DesignIV-Equipe4/EchoLink/Kicad/EchoLink/EchoLink.csv

Reference | Qty | Value | DNP | Exclude from BOM | Exclude from Board | Footprint | Datasheet | Manufacturer_Part_Number | DigitKey_Part_Number
C1,C2,C4,C5,C6,C7,C9,C12,C13,C17,C20,C21,C24,C26,C27 | 15 | 100nF |  |  |  | Capacitor_SMD:C_0603_1608Metric | https://www.digikey.ca/en/products/detail/kemet/C0603C104K5RACTU/1465594 | C0603C104K5RACTU | 399-C0603C104K5RACTUCT-ND
C3 | 1 | 4.7uF |  |  |  | Capacitor_SMD:C_0603_1608Metric | https://www.digikey.ca/en/products/detail/murata-electronics/GRM188R61E475KE11D/3900465 | GRM188R61E475KE11D | 490-7203-1-ND
C8,C19,C22,C28 | 4 | 10uF |  |  |  | Capacitor_SMD:C_0603_1608Metric | https://www.digikey.ca/en/products/detail/taiyo-yuden/LMK107BBJ106MALT/3662195 | LMK107BBJ106MALT | 587-3258-1-ND
C10,C14 | 2 | 22pF |  |  |  | Capacitor_SMD:C_0402_1005Metric | https://www.digikey.ca/en/products/detail/murata-electronics/GCM1555C1H220FA16D/7363195 | QSCT251Q220F1GV001E | 490-16451-1-ND
C11,C15 | 2 | 10nF |  |  |  | Capacitor_SMD:C_0402_1005Metric | https://www.digikey.ca/en/products/detail/murata-electronics/GRM155R71C103KA01D/587215 | GRM155R71C103KA01D | 490-1313-1-ND
C16,C23,C29 | 3 | 1uF |  |  |  | Capacitor_SMD:C_0603_1608Metric | https://www.digikey.ca/en/products/detail/kemet/C0603C105K4RACTU/2199788 | C0603C105K4RACTU | 399-C0603C105K4RACTUCT-ND
C18 | 1 | T520D227M010ATE018 |  |  |  | EchoLink_Lib:CAPMP7.6X4.3_3.1N_KEM | https://www.digikey.ca/en/products/detail/yageo/CC0603KRX7R9BB103/302819 | T520D227M010ATE018 | 399-4045-1-ND
C25,C30 | 2 | 10nF |  |  |  | Capacitor_SMD:C_0603_1608Metric | https://www.digikey.ca/en/products/detail/samsung-electro-mechanics/CL21B103KAANNNC/3888092 | CC0603KRX7R9BB103 | 311-1085-1-ND
D2,D3 | 2 | GREEN |  |  |  | Resistor_SMD:R_0603_1608Metric | https://www.digikey.ca/en/products/detail/qt-brightek-qtb/QBLP601-AG15/16499667 | QBLP601-AG15 | 1516-QBLP601-AG15CT-ND
FB1,FB2 | 2 | 120R |  |  |  | Resistor_SMD:R_0805_2012Metric | https://www.digikey.ca/en/products/detail/fair-rite-products-corp/2508051217Y6/8594305 | 2508051217Y6 | 1934-1472-1-ND
J1 | 1 | 142-0701-801 |  |  |  | EchoLink_Lib:CONN_142-0701-801 | https://www.digikey.ca/en/products/detail/cinch-connectivity-solutions-johnson/142-0701-801/35280 | 142-0701-801 | J502-ND
J2 | 1 | Conn_01x04 |  |  |  | EchoLink_Lib:CONN_SD-43045-008_04_MOL | https://www.digikey.ca/en/products/detail/molex/0430450423/3044577 | 0430450423 | WM7485-ND
J3 | 1 | Conn_02x04_Counter_Clockwise |  |  |  | EchoLink_Lib:CONN_SD-43045-008_08_MOL | https://www.digikey.ca/en/products/detail/molex/0430450821/1635026 | 0430450821 | WM2675-ND
J6 | 1 | Conn_01x03 |  |  |  | EchoLink_Lib:CONN_SD-43650-002_03_MOL | https://www.digikey.ca/en/products/detail/molex/0436500303/269000 | 0436500303 | 23-0436500303-ND
J7 | 1 | Conn_01x06_Pin |  |  |  | Connector_PinHeader_2.54mm:PinHeader_1x06_P2.54mm_Vertical
R1,R3,R4,R5,R9,R11,R14 | 7 | 10k |  |  |  | Resistor_SMD:R_0603_1608Metric | https://www.digikey.ca/en/products/detail/yageo/RC0603FR-0710KL/726880 | RC0603FR-0710KL | 311-10.0KHRCT-ND
R2,R8,R13,R17,R18 | 5 | 1.5k |  |  |  | Resistor_SMD:R_0603_1608Metric | https://www.digikey.ca/en/products/detail/panasonic-electronic-components/ERA-3AEB152V/1465858 | ERA-3AEB152V | P1.5KDBCT-ND
R6,R7,R12 | 3 | 22R |  |  |  | Capacitor_SMD:C_0603_1608Metric | https://www.digikey.ca/en/products/detail/stackpole-electronics-inc/RMCF0603FT22R0/1760726 | RMCF0603FT22R0 | RMCF0603FT22R0CT-ND
R10 | 1 | 10R |  |  |  | Resistor_SMD:R_0603_1608Metric | https://www.digikey.ca/en/products/detail/yageo/RC0805FR-0710RL/727534 | RC0805FR-0710RL | 311-10.0CRCT-ND
R15,R16 | 2 | 59R |  |  |  | Resistor_SMD:R_0603_1608Metric | https://www.digikey.ca/en/products/detail/koa-speer-electronics-inc/RK73H1JTTD59R0F/9845371 | RK73H1JTTD59R0F | 2019-RK73H1JTTD59R0FCT-ND
SW1,SW2 | 2 | PTS526 SM15 SMTR2 LFS |  |  |  | SON4_PTS526 SM15 SMTR2 LFS_CNK | https://www.digikey.ca/en/products/detail/c-k/PTS526SM15SMTR2-LFS/10056625 | PTS526SM15SMTR2 LFS | CKN12220-1-ND
TP1,TP2,TP3,TP4,TP5,TP6 | 6 | TestPoint |  |  |  | TestPoint:TestPoint_Pad_D1.0mm
U1 | 1 | STM32L433CCT6 |  |  |  | EchoLink_Lib:QFP50P900X900X160-48N | https://www.digikey.ca/en/products/detail/stmicroelectronics/STM32L433CCT6/6132750 | STM32L433CCT6 | 497-16579-ND
U2 | 1 | E22-400M33S | DNP |  |  | EchoLink_Lib:E22-400M33S | https://www.cdebyte.com/products/E22-400M33S/4#Downloads
U3 | 1 | ISOW1044 |  |  |  | EchoLink_Lib:ISOW1044BDFMR | https://www.digikey.com/en/products/detail/texas-instruments/ISOW1044BDFMR/18159254 | ISOW1044BDFMR | 296-ISOW1044BDFMRCT-ND
Y1 | 1 | WE-XTAL_HC49 |  |  |  | EchoLink_Lib:WE-XTAL_HC49 | https://www.digikey.ca/en/products/detail/w%C3%BCrth-elektronik/830050510/13900454 | 830050510 | 1923-830050510CT-ND
