DesignIV-Equipe4/EchoLink/Kicad/Components/142_0701_801/142-0701-801.step

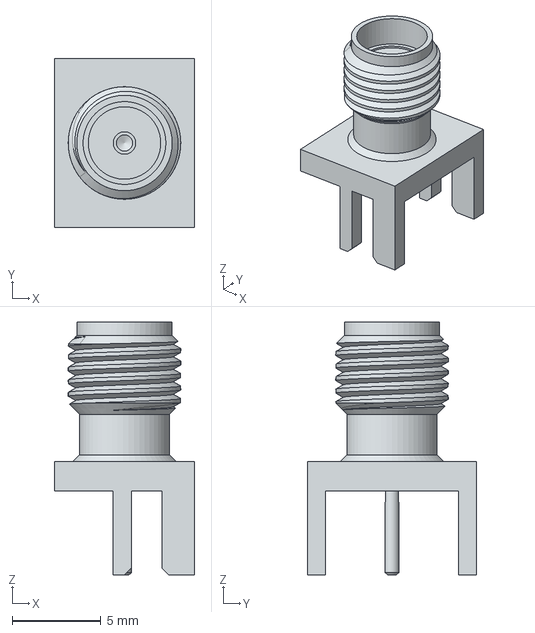
[picture p1: CAD file, 2026-09-06]
Kicad/Components/142_0701_801/142-0701-801.step
7.92 x 9.53 x 14.3 mm
