DesignIV-Equipe4/EchoLink/Kicad/Components/EEHZU1E471P/EEHZU1E471P.step

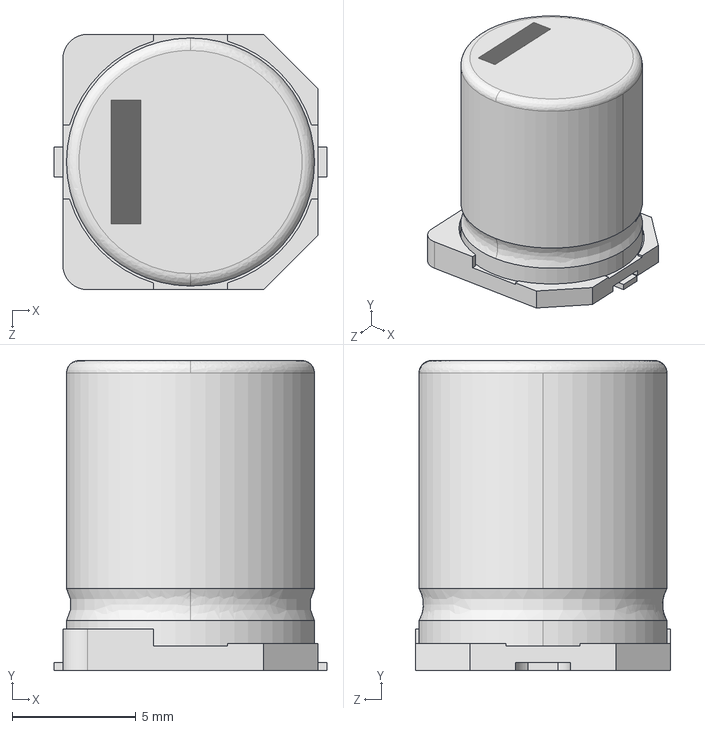
[picture p2: CAD file, 2026-09-08]
Kicad/Components/EEHZU1E471P/EEHZU1E471P.step
11.0 x 12.5 x 10.3 mm
