DesignIV-Equipe4/EchoLink/Kicad/Components/HM-11/HM11.stp

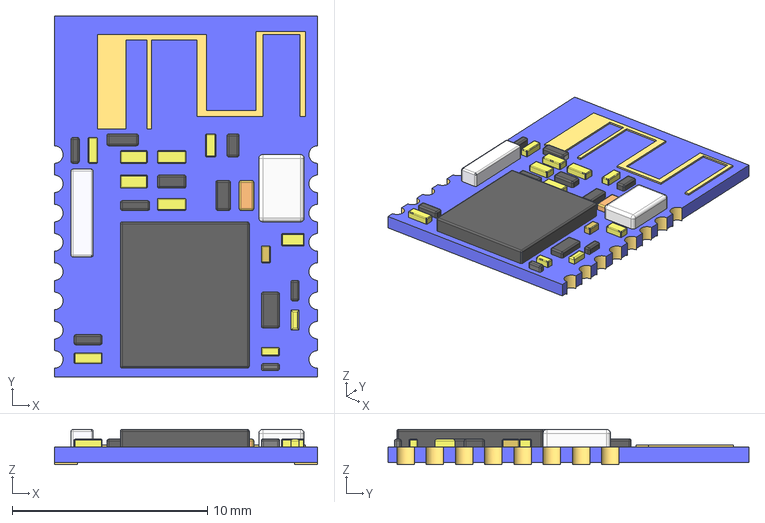
[picture p3: CAD file, 2026-09-06]
Kicad/Components/HM-11/HM11.stp
13.5 x 18.5 x 1.80 mm
