DesignIV-Equipe4/EchoLink/Kicad/Components/ISOW1044BDFMR/ISOW1044BDFMR.stp

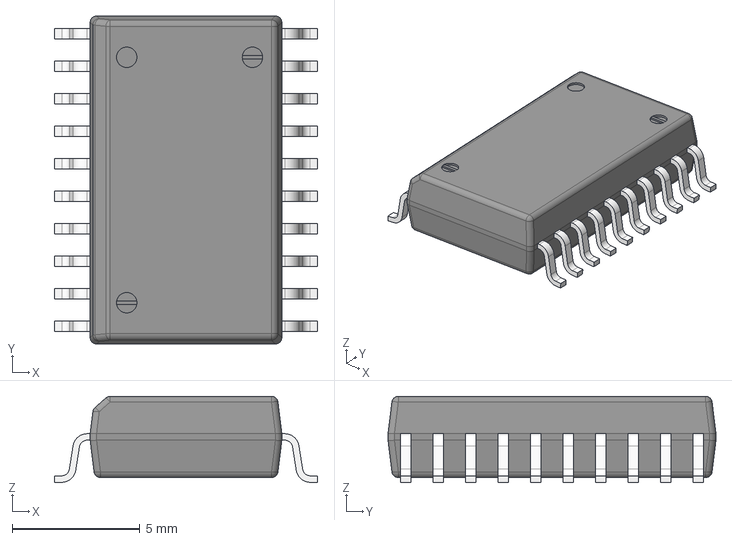
[picture p4: CAD file, 2026-10-04]
Kicad/Components/ISOW1044BDFMR/ISOW1044BDFMR.stp
10.3 x 12.8 x 3.38 mm
BODY-SSOP
LEAD-SSOP x 20
