DesignIV-Equipe4/EchoLink/Kicad/Components/MAX3221IPWR/MAX3221IPWR.step

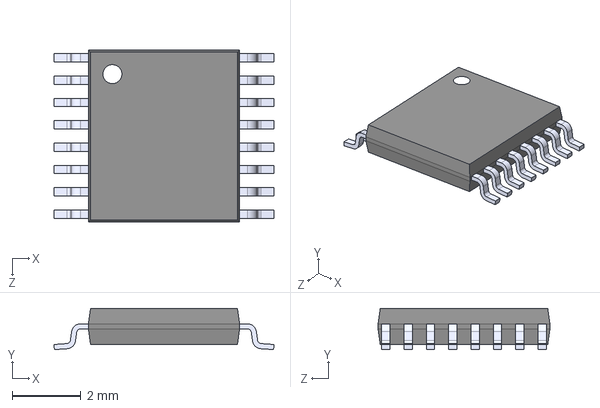
[picture p5: CAD file, 2026-09-06]
Kicad/Components/MAX3221IPWR/MAX3221IPWR.step
6.40 x 1.20 x 5.00 mm
