DesignIV-Equipe4/EchoLink/Kicad/Components/STM32L433CCT6/STM32L433CCT6.step

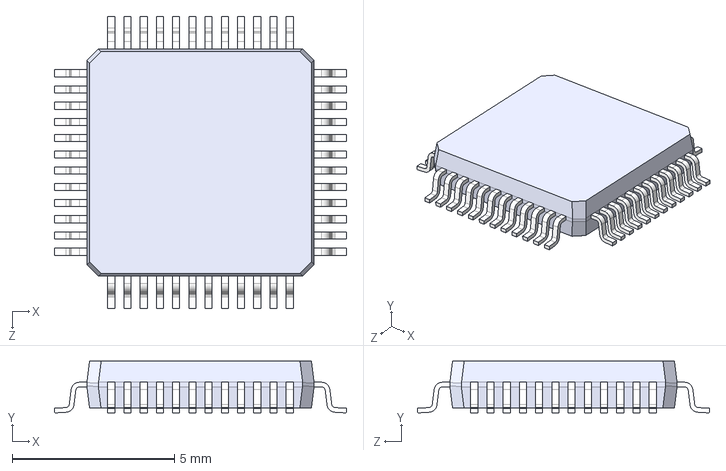
[picture p6: CAD file, 2026-09-06]
Kicad/Components/STM32L433CCT6/STM32L433CCT6.step
9.00 x 1.60 x 9.00 mm
