DesignIV-Equipe4/EchoLink/Kicad/Components/T520D227M010ATE018/T520D227M010ATE018.step

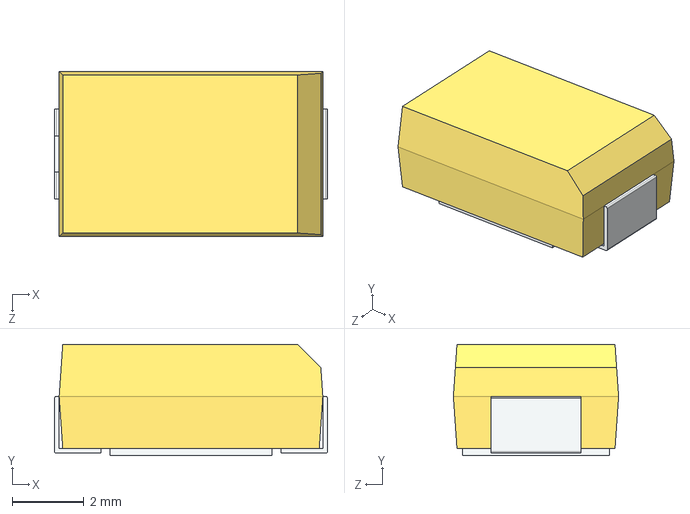
[picture p7: CAD file, 2026-11-02]
Kicad/Components/T520D227M010ATE018/T520D227M010ATE018.step
7.60 x 3.10 x 4.60 mm
