DesignIV-Equipe4/EchoLink/Kicad/Components/WE-XTAL_HC49/WE-XTAL_HC49.step

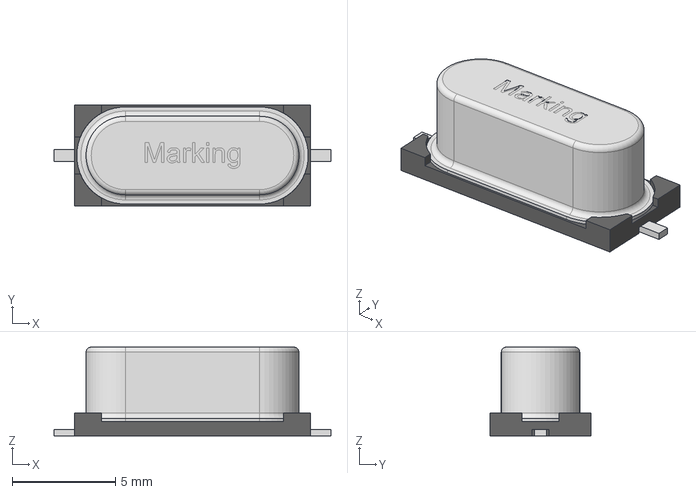
[picture p8: CAD file, 2026-10-06]
Kicad/Components/WE-XTAL_HC49/WE-XTAL_HC49.step
13.4 x 4.90 x 4.30 mm
Base
Housing
