DesignIV-Equipe4/EchoLink/Kicad/Components/430450423/430450423.stp

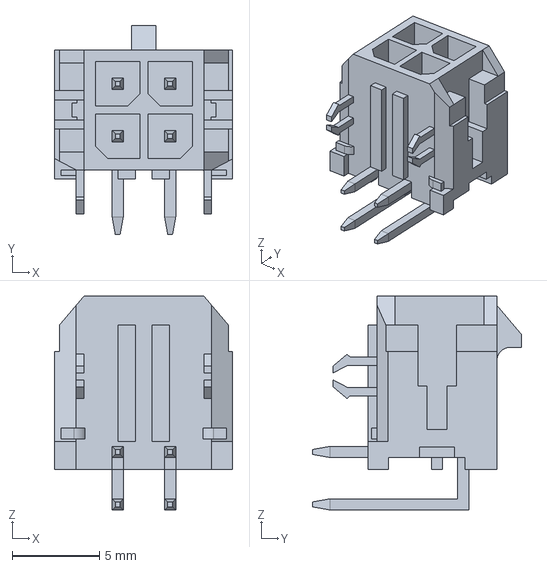
[picture p9: CAD file, 2026-11-09]
Kicad/Components/430450423/430450423.stp
10.2 x 11.9 x 12.2 mm
