DesignIV-Equipe4/EchoLink/Kicad/Components/430451021/430451021.step

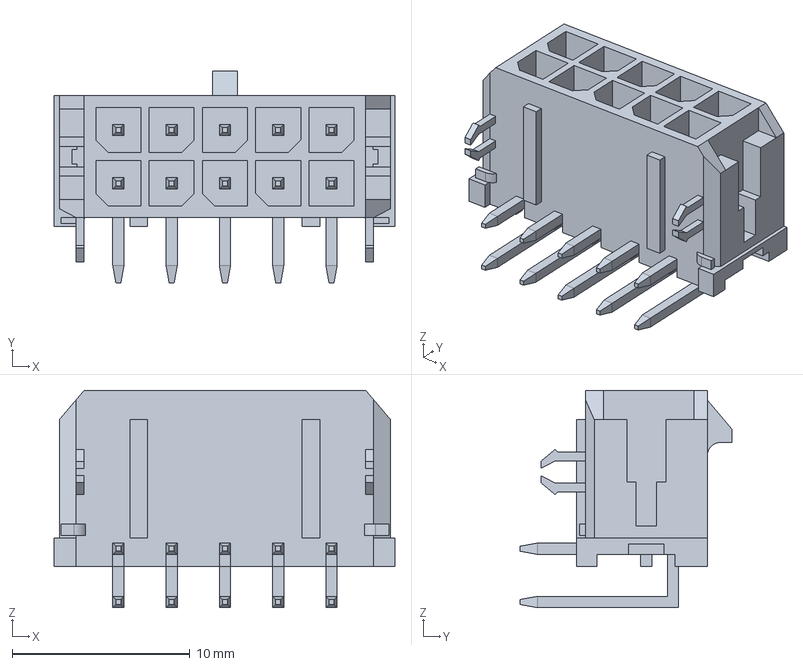
[picture p10: CAD file, 2026-11-02]
Kicad/Components/430451021/430451021.step
19.2 x 11.9 x 12.2 mm
