DesignIV-Equipe4/EchoLink/Kicad/Components/436500203/436500203.stp

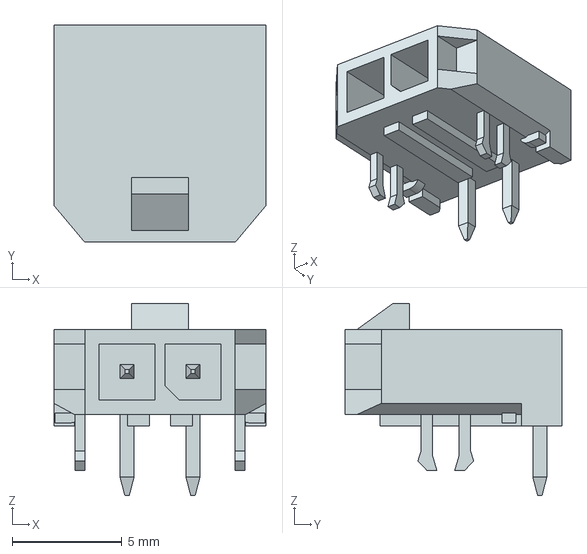
[picture p11: CAD file, 2026-11-02]
Kicad/Components/436500203/436500203.stp
9.65 x 9.90 x 8.75 mm
