DesignIV-Equipe4/EchoLink/Kicad/Components/436500303/436500303.stp

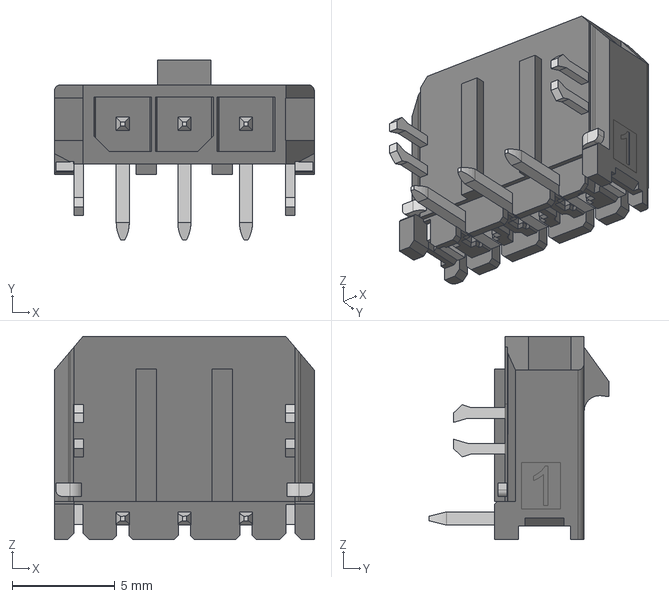
[picture p12: CAD file, 2026-11-02]
Kicad/Components/436500303/436500303.stp
12.7 x 8.75 x 9.90 mm
