DesignIV-Equipe4/EchoLink/Kicad/Components/436500404/436500404.step

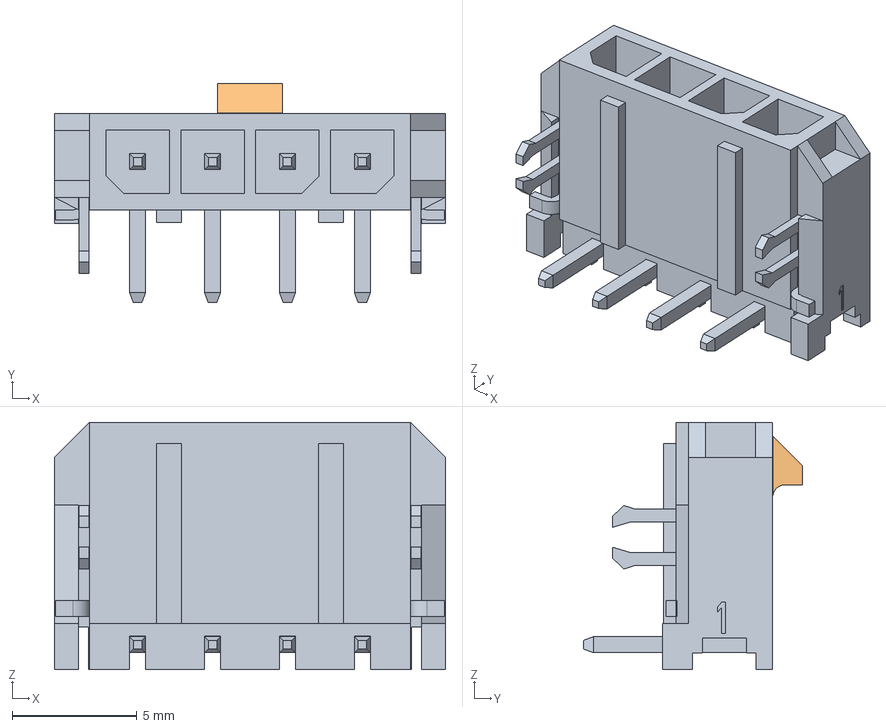
[picture p13: CAD file, 2026-09-06]
Kicad/Components/436500404/436500404.step
15.7 x 8.79 x 9.90 mm
