DesignIV-Equipe4/EchoLink/Kicad/Components/436500900/436500900.stp

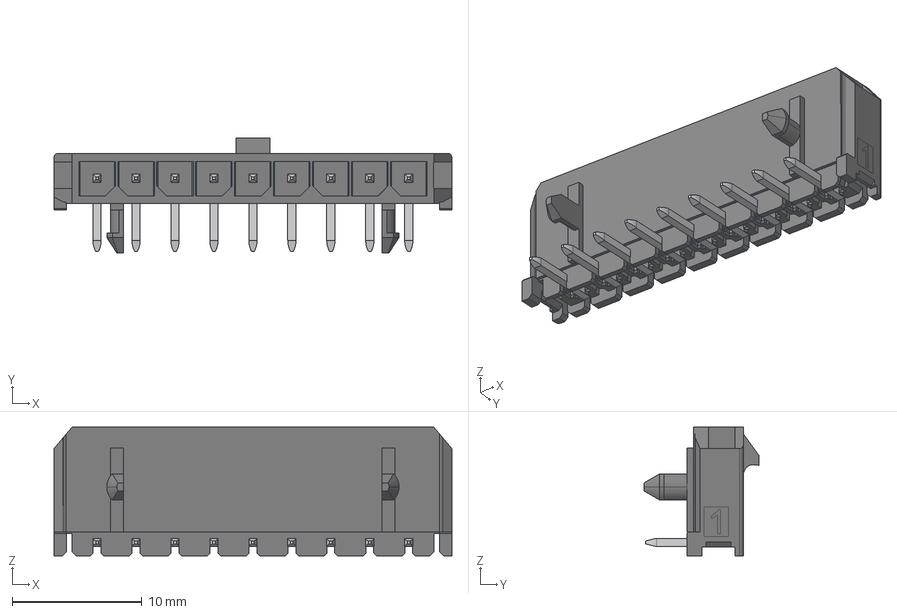
[picture p14: CAD file, 2026-11-02]
Kicad/Components/436500900/436500900.stp
30.6 x 8.87 x 9.90 mm
