DesignIV-Equipe4/EchoLink/(list of files, drawings)

Other design files:
Kicad/Components/E22-400M33S/E22-400M33S.PcbLib
