DesignIV-Equipe4/EchoLink/Kicad/EchoLink/EchoLink.kicad_pcb

## KiCad design Kicad/EchoLink/EchoLink.kicad_pcb (2026-11-11)

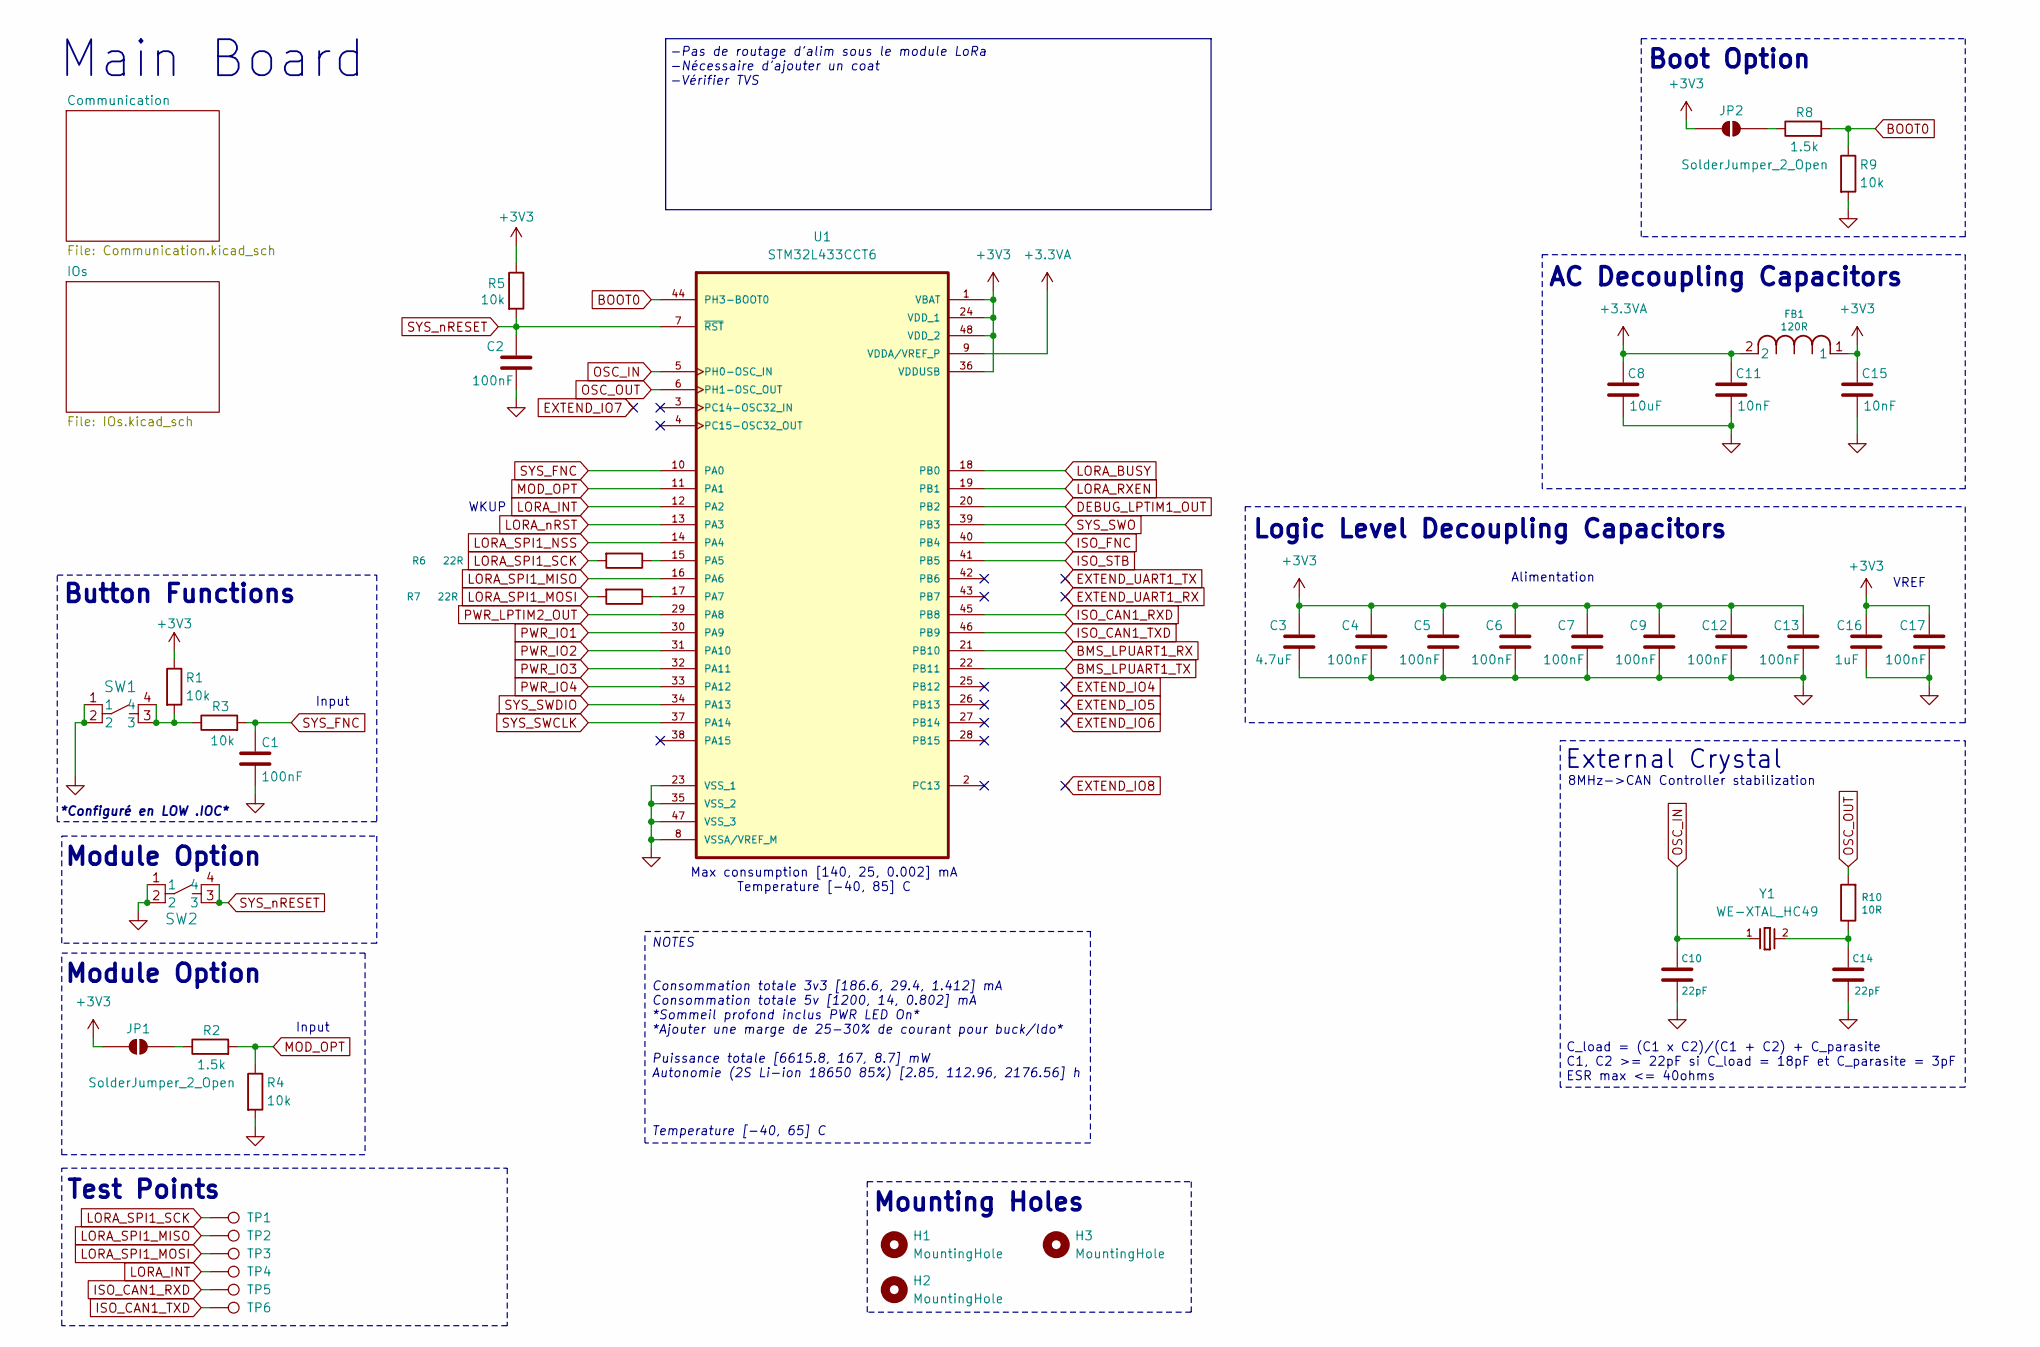
[picture p15: schematic EchoLink.kicad_sch]

Parts:
C1, C2, C4, C5, C6, C7, C9, C12, C13, C17: 100nF; C_0603_1608Metric; Manufacturer_Part_Number C0603C104K5RACTU; DigiKey_Part_Number 311-3342-1-ND
C3: 4.7uF; C_0603_1608Metric; Manufacturer_Part_Number GRM188R61E475KE11D; DigiKey_Part_Number 311-3342-1-ND
C8: 10uF; C_0603_1608Metric; Manufacturer_Part_Number LMK107BBJ106MALT; DigiKey_Part_Number 4713-GMC10X5R106M35NTTR-ND
C10, C14: 22pF; C_0402_1005Metric; Manufacturer_Part_Number QSCT251Q220F1GV001E; DigiKey_Part_Number 712-QSCT251Q220F1GV001ECT-ND
C11, C15: 10nF; C_0402_1005Metric; Manufacturer_Part_Number GRM155R71C103KA01D; DigiKey_Part_Number 490-1313-1-ND
C16: 1uF; C_0603_1608Metric; Manufacturer_Part_Number C0603C105K4RACTU; DigiKey_Part_Number 311-3342-1-ND
FB1: 120R; R_0805_2012Metric; Manufacturer_Part_Number 2508051217Y6; DigiKey_Part_Number 1934-1472-1-ND
H1, H2, H3: MountingHole; MountingHole_2.2mm_M2_Pad_Via
JP1, JP2: SolderJumper_2_Open; SolderJumper-2_P1.3mm_Open_RoundedPad1.0x1.5mm
R1, R4, R5, R9: 10k; R_0603_1608Metric; Manufacturer_Part_Number RC0603FR-0710KL; DigiKey_Part_Number 311-10.0KHRCT-ND
R2, R8: 1.5k; R_0603_1608Metric; Manufacturer_Part_Number ERA-3AEB152V; DigiKey_Part_Number P1.5KDBCT-ND
R3: 10k; R_0603_1608Metric; Manufacturer_Part_Number RC0603FR-0710KL; DigiKey_Part_Number P1.5KDBCT-ND
R6, R7: 22R; C_0603_1608Metric; Manufacturer_Part_Number RMCF0603FT22R0; DigiKey_Part_Number YAG3460CT-ND
R10: 10R; R_0603_1608Metric; Manufacturer_Part_Number RC0805FR-0710RL; DigiKey_Part_Number 311-10.0CRCT-ND
SW1, SW2: PTS526 SM15 SMTR2 LFS; SON4_PTS526 SM15 SMTR2 LFS_CNK; Manufacturer_Part_Number PTS526SM15SMTR2 LFS; DigitKey_Part_Number CKN12220-1-ND
TP1, TP2, TP3, TP4, TP5, TP6: TestPoint; TestPoint_Pad_D1.0mm
U1: STM32L433CCT6; QFP50P900X900X160-48N; Manufacturer_Part_Number STM32L433CCT6; DigiKey_Part_Number 497-16579-ND
Y1: WE-XTAL_HC49; Manufacturer_Part_Number 830050510; DigiKey_Part_Number 1923-830050510CT-ND

Connections:
+3.3VA: C8.1, C11.1, FB1.2, U1.9 (VDDA/VREF_P)
+3V3: C3.1, C4.1, C5.1, C6.1, C7.1, C9.1, C12.1, C13.1, C15.1, C16.1, C17.1, FB1.1, JP1.1 (A), JP2.1 (A), R1.1, R5.1, U1.1 (VBAT), U1.24 (VDD_1), U1.36 (VDDUSB), U1.48 (VDD_2); also elsewhere on the board
BMS_LPUART1_RX: U1.21 (PB10); also elsewhere on the board
BMS_LPUART1_TX: U1.22 (PB11); also elsewhere on the board
BOOT0: R8.2, R9.1, U1.44 (PH3-BOOT0)
DEBUG_LPTIM1_OUT: U1.20 (PB2); also elsewhere on the board
GND: C1.2, C2.2, C3.2, C4.2, C5.2, C6.2, C7.2, C8.2, C9.2, C10.1, C11.2, C12.2, C13.2, C14.1, C15.2, C16.2, C17.2, R4.2, R9.2, SW1.1, SW1.2, SW2.1, SW2.2, U1.8 (VSSA/VREF_M), U1.23 (VSS_1), U1.35 (VSS_2), U1.47 (VSS_3); also elsewhere on the board
ISO_CAN1_RXD: TP5.1 (1_1), U1.45 (PB8); also elsewhere on the board
ISO_CAN1_TXD: TP6.1 (1_1), U1.46 (PB9); also elsewhere on the board
ISO_FNC: U1.40 (PB4); also elsewhere on the board
ISO_STB: U1.41 (PB5); also elsewhere on the board
LORA_BUSY: U1.18 (PB0); also elsewhere on the board
LORA_INT: TP4.1 (1_1), U1.12 (PA2); also elsewhere on the board
LORA_RXEN: U1.19 (PB1); also elsewhere on the board
LORA_SPI1_MISO: TP2.1 (1_1), U1.16 (PA6); also elsewhere on the board
LORA_SPI1_MOSI: R7.2, TP3.1 (1_1); also elsewhere on the board
LORA_SPI1_NSS: U1.14 (PA4); also elsewhere on the board
LORA_SPI1_SCK: R6.2, TP1.1 (1_1); also elsewhere on the board
LORA_nRST: U1.13 (PA3); also elsewhere on the board
MOD_OPT: R2.2, R4.1, U1.11 (PA1)
unnamed: C14.2, R10.1, Y1.2
unnamed: JP1.2 (B), R2.1
unnamed: JP2.2 (B), R8.1
unnamed: R1.2, R3.1, SW1.3, SW1.4
unnamed: R6.1, U1.15 (PA5)
unnamed: R7.1, U1.17 (PA7)
OSC_IN: C10.2, U1.5 (PH0-OSC_IN), Y1.1
OSC_OUT: R10.2, U1.6 (PH1-OSC_OUT)
PWR_IO1: U1.30 (PA9); also elsewhere on the board
PWR_IO2: U1.31 (PA10); also elsewhere on the board
PWR_IO3: U1.32 (PA11); also elsewhere on the board
PWR_IO4: U1.33 (PA12); also elsewhere on the board
PWR_LPTIM2_OUT: U1.29 (PA8); also elsewhere on the board
SYS_FNC: C1.1, R3.2, U1.10 (PA0)
SYS_SWCLK: U1.37 (PA14); also elsewhere on the board
SYS_SWDIO: U1.34 (PA13); also elsewhere on the board
SYS_SWO: U1.39 (PB3); also elsewhere on the board
SYS_nRESET: C2.1, R5.2, SW2.3, SW2.4, U1.7 (~RST); also elsewhere on the board

Notes on the sheet:
Module Option
8MHz->CAN Controller stabilization
*Configuré en LOW .IOC*
WKUP
External Crystal
Main Board
AC Decoupling Capacitors
Logic Level Decoupling Capacitors
Boot Option
Input
C_load = (C1 x C2)/(C1 + C2) + C_parasite C1, C2 >= 22pF si C_load = 18pF et C_parasite = 3pF ESR max <= 40ohms
VREF
-Pas de routage d'alim sous le module LoRa -Nécessaire d'ajouter un coat -Vérifier TVS
Test Points
Alimentation
Max consumption [140, 25, 0.002] mA Temperature [-40, 85] C
NOTES Consommation totale 3v3 [186.6, 29.4, 1.412] mA Consommation totale 5v [1200, 14, 0.802] mA *Sommeil profond inclus PWR LED On* *Ajouter une marge de 25-30% de courant pour buck/ldo* Puissance totale [6615.8, 167, 8.7] mW Autonomie (2S Li-ion 18650 85%) [2.85, 112.96, 2176.56] h Temperature [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
Mounting Holes
Button Functions

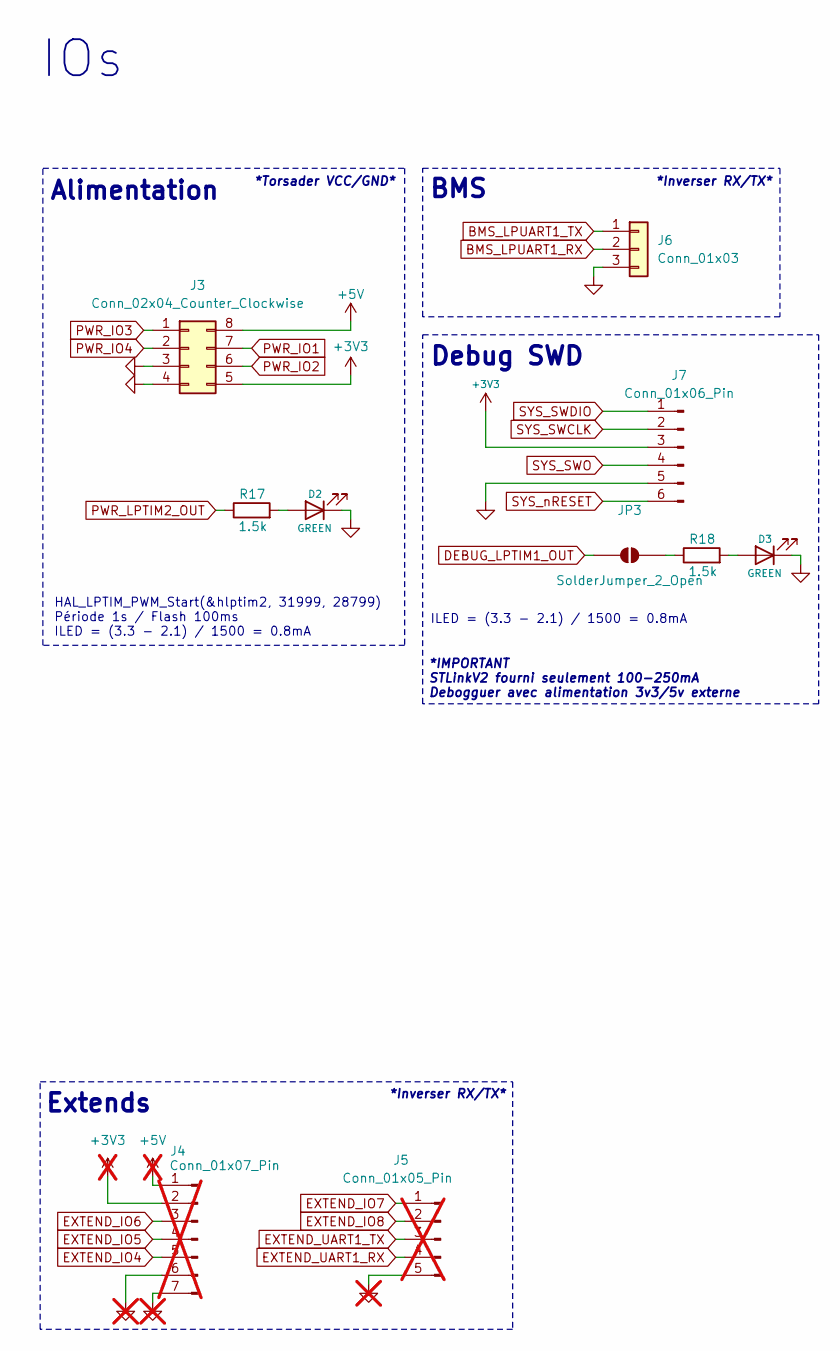
[picture p16: schematic IOs.kicad_sch]

Parts:
D2, D3: GREEN; R_0603_1608Metric; Manufacturer_Part_Number QBLP601-AG15; DigiKey_Part_Number 1516-QBLP601-AG15CT-ND
J3: Conn_02x04_Counter_Clockwise; CONN_SD-43045-008_08_MOL; Manufacturer_Part_Number 0430450821; DigitKey_Part_Number WM2675-ND
J4: Conn_01x07_Pin; PinHeader_1x07_P2.54mm_Vertical; not fitted
J5: Conn_01x05_Pin; PinHeader_1x05_P2.54mm_Vertical; not fitted
J6: Conn_01x03; CONN_SD-43650-002_03_MOL; Manufacturer_Part_Number 0436500303; DigitKey_Part_Number 23-0436500303-ND
J7: Conn_01x06_Pin; PinHeader_1x06_P2.54mm_Vertical
JP3: SolderJumper_2_Open; SolderJumper-2_P1.3mm_Open_RoundedPad1.0x1.5mm
R17, R18: 1.5k; R_0603_1608Metric; Manufacturer_Part_Number ERA-3AEB152V; DigiKey_Part_Number P1.5KDBCT-ND

Connections:
+3V3: J3.5, J4.2, J7.3; also elsewhere on the board
+5V: J3.8, J4.1; also elsewhere on the board
BMS_LPUART1_RX: J6.2; also elsewhere on the board
BMS_LPUART1_TX: J6.1; also elsewhere on the board
DEBUG_LPTIM1_OUT: JP3.1 (A); also elsewhere on the board
GND: D2.1 (K), D3.1 (K), J3.3, J3.4, J4.6, J4.7, J5.5, J6.3, J7.5; also elsewhere on the board
unnamed: D2.2 (A), R17.2
unnamed: D3.2 (A), R18.2
unnamed: JP3.2 (B), R18.1
PWR_IO1: J3.7; also elsewhere on the board
PWR_IO2: J3.6; also elsewhere on the board
PWR_IO3: J3.1; also elsewhere on the board
PWR_IO4: J3.2; also elsewhere on the board
PWR_LPTIM2_OUT: R17.1; also elsewhere on the board
SYS_SWCLK: J7.2; also elsewhere on the board
SYS_SWDIO: J7.1; also elsewhere on the board
SYS_SWO: J7.4; also elsewhere on the board
SYS_nRESET: J7.6; also elsewhere on the board

Notes on the sheet:
IOs
BMS
Extends
*Inverser RX/TX*
*IMPORTANT STLinkV2 fourni seulement 100-250mA Debogguer avec alimentation 3v3/5v externe
HAL_LPTIM_PWM_Start(&hlptim2, 31999, 28799) Période 1s / Flash 100ms ILED = (3.3 - 2.1) / 1500 = 0.8mA
Debug SWD
Alimentation
*Torsader VCC/GND*
ILED = (3.3 - 2.1) / 1500 = 0.8mA

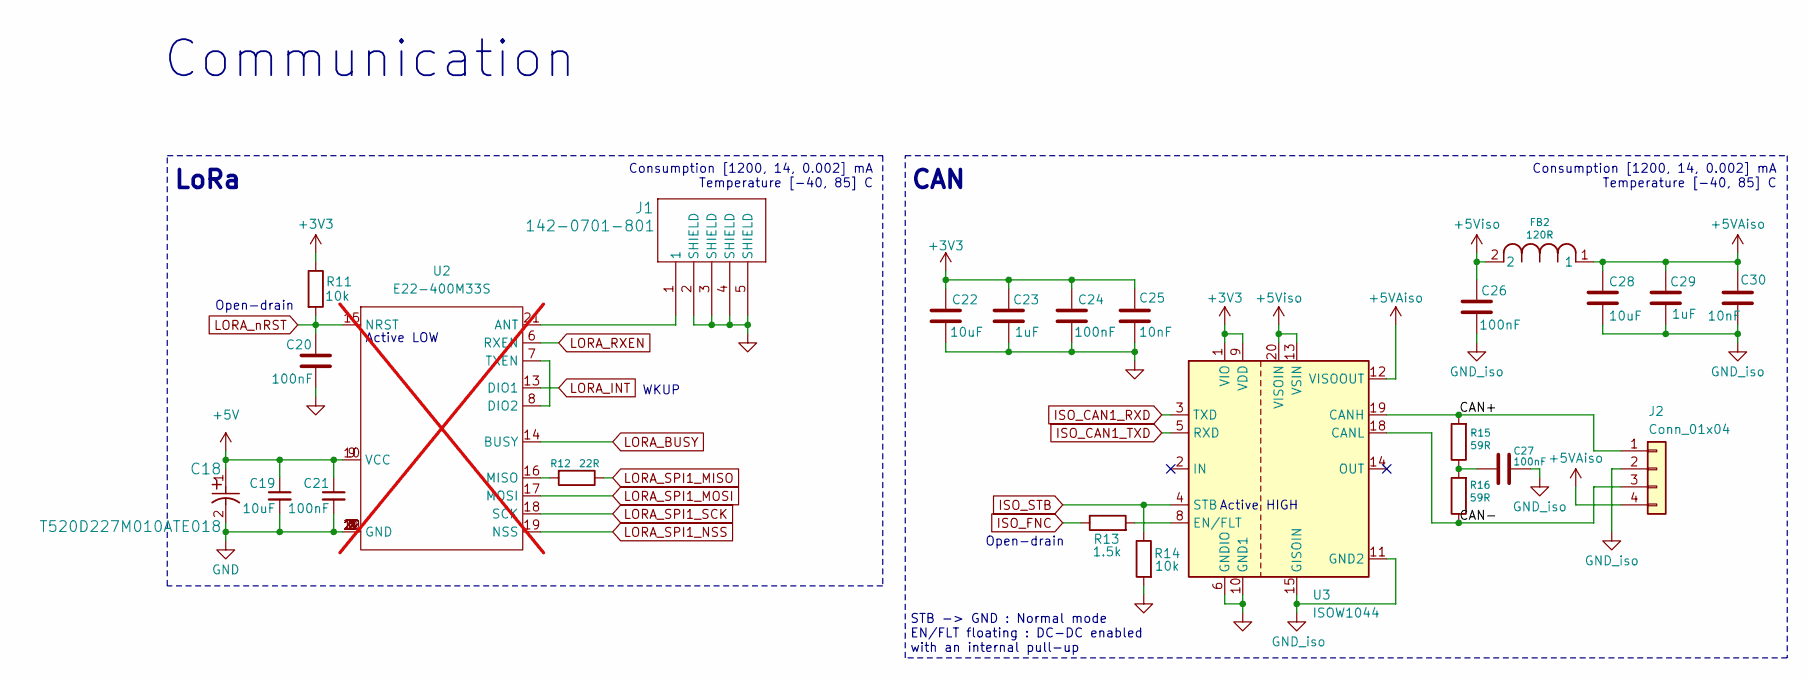
[picture p17: schematic Communication.kicad_sch]

Parts:
C18: T520D227M010ATE018; CAPMP7.6X4.3_3.1N_KEM; Manufacturer_Part_Number T520D227M010ATE018; DigitKey_Part_Number 399-4045-1-ND
C19: 10uF; C_0603_1608Metric; Manufacturer_Part_Number LMK107BBJ106MALT; DigitKey_Part_Number 587-3258-1-ND
C20: 100nF; C_0603_1608Metric; Manufacturer_Part_Number C0603C104K5RACTU; DigiKey_Part_Number 311-3342-1-ND
C21: 100nF; C_0603_1608Metric; Manufacturer_Part_Number C0603C104K5RACTU; DigitKey_Part_Number 399-C0603C104K5RACTUCT-ND
C22, C28: 10uF; C_0603_1608Metric; Manufacturer_Part_Number LMK107BBJ106MALT; DigiKey_Part_Number 1276-2891-1-ND
C23, C29: 1uF; C_0603_1608Metric; Manufacturer_Part_Number C0603C105K4RACTU; DigiKey_Part_Number 1276-1029-1-ND
C24, C26, C27: 100nF; C_0603_1608Metric; Manufacturer_Part_Number C0603C104K5RACTU; DigiKey_Part_Number 399-C0603C104K3RACTUCT-ND
C25, C30: 10nF; C_0603_1608Metric; Manufacturer_Part_Number CC0603KRX7R9BB103; DigiKey_Part_Number 1276-2434-1-ND
FB2: 120R; R_0805_2012Metric; Manufacturer_Part_Number 2508051217Y6; DigiKey_Part_Number 1934-1472-1-ND
J1: 142-0701-801; CONN_142-0701-801; Manufacturer_Part_Number 142-0701-801; DigitKey_Part_Number J502-ND
J2: Conn_01x04; CONN_SD-43045-008_04_MOL; Manufacturer_Part_Number 0430450423; DigitKey_Part_Number WM7485-ND
R11, R14: 10k; R_0603_1608Metric; Manufacturer_Part_Number RC0603FR-0710KL; DigiKey_Part_Number 311-10.0KHRCT-ND
R12: 22R; C_0603_1608Metric; Manufacturer_Part_Number RMCF0603FT22R0; DigiKey_Part_Number YAG3460CT-ND
R13: 1.5k; R_0603_1608Metric; Manufacturer_Part_Number ERA-3AEB152V; DigiKey_Part_Number P1.5KDBCT-ND
R15, R16: 59R; R_0603_1608Metric; Manufacturer_Part_Number RK73H1JTTD59R0F; DigiKey_Part_Number 311-59.0CRCT-ND
U2: E22-400M33S; not fitted
U3: ISOW1044; ISOW1044BDFMR; Manufacturer_Part_Number ISOW1044BDFMR; DigiKey_Part_Number 296-ISOW1044BDFMRCT-ND

Connections:
+3V3: C22.1, C23.1, C24.1, C25.1, R11.1, U3.1 (VIO), U3.9 (VDD); also elsewhere on the board
+5V: C18.1, C19.1, C21.1, U2.9 (VCC), U2.10 (VCC); also elsewhere on the board
+5VAiso: C28.1, C29.1, C30.1, FB2.1, J2.4, U3.12 (VISOOUT); also elsewhere on the board
+5Viso: C26.1, FB2.2, U3.13 (VSIN), U3.20 (VISOIN)
/Communication/CAN+: J2.1, R15.2, U3.19 (CANH)
/Communication/CAN-: J2.3, R16.1, U3.18 (CANL)
GND: C18.2, C19.2, C20.2, C21.2, C22.2, C23.2, C24.2, C25.2, J1.2 (SHIELD), J1.3 (SHIELD), J1.4 (SHIELD), J1.5 (SHIELD), R14.2, U2.0 (GND), U2.1 (GND), U2.2 (GND), U2.3 (GND), U2.4 (GND), U2.5 (GND), U2.11 (GND), U2.12 (GND), U2.20 (GND), U2.22 (GND), U3.6 (GNDIO), U3.10 (GND1); also elsewhere on the board
GND_iso: C26.2, C27.2, C28.2, C29.2, C30.2, J2.2, U3.11 (GND2), U3.15 (GISOIN), U3.16 (GISOIN), U3.17 (GISOIN); also elsewhere on the board
ISO_CAN1_RXD: U3.3 (TXD); also elsewhere on the board
ISO_CAN1_TXD: U3.5 (RXD); also elsewhere on the board
ISO_FNC: R13.1; also elsewhere on the board
ISO_STB: R14.1, U3.4 (STB); also elsewhere on the board
LORA_BUSY: U2.14 (BUSY); also elsewhere on the board
LORA_INT: U2.13 (DIO1); also elsewhere on the board
LORA_RXEN: U2.6 (RXEN); also elsewhere on the board
LORA_SPI1_MISO: R12.1; also elsewhere on the board
LORA_SPI1_MOSI: U2.17 (MOSI); also elsewhere on the board
LORA_SPI1_NSS: U2.19 (NSS); also elsewhere on the board
LORA_SPI1_SCK: U2.18 (SCK); also elsewhere on the board
LORA_nRST: C20.1, R11.2, U2.15 (NRST); also elsewhere on the board
unnamed: C27.1, R15.1, R16.2
unnamed: J1.1, U2.21 (ANT)
unnamed: U2.7 (TXEN), U2.8 (DIO2)
unnamed: R12.2, U2.16 (MISO)
unnamed: R13.2, U3.8 (EN/FLT)

Notes on the sheet:
WKUP
Active HIGH
Open-drain
Consumption [1200, 14, 0.002] mA Temperature [-40, 85] C
Communication
STB -> GND : Normal mode EN/FLT floating : DC-DC enabled with an internal pull-up
LoRa
Active LOW
CAN

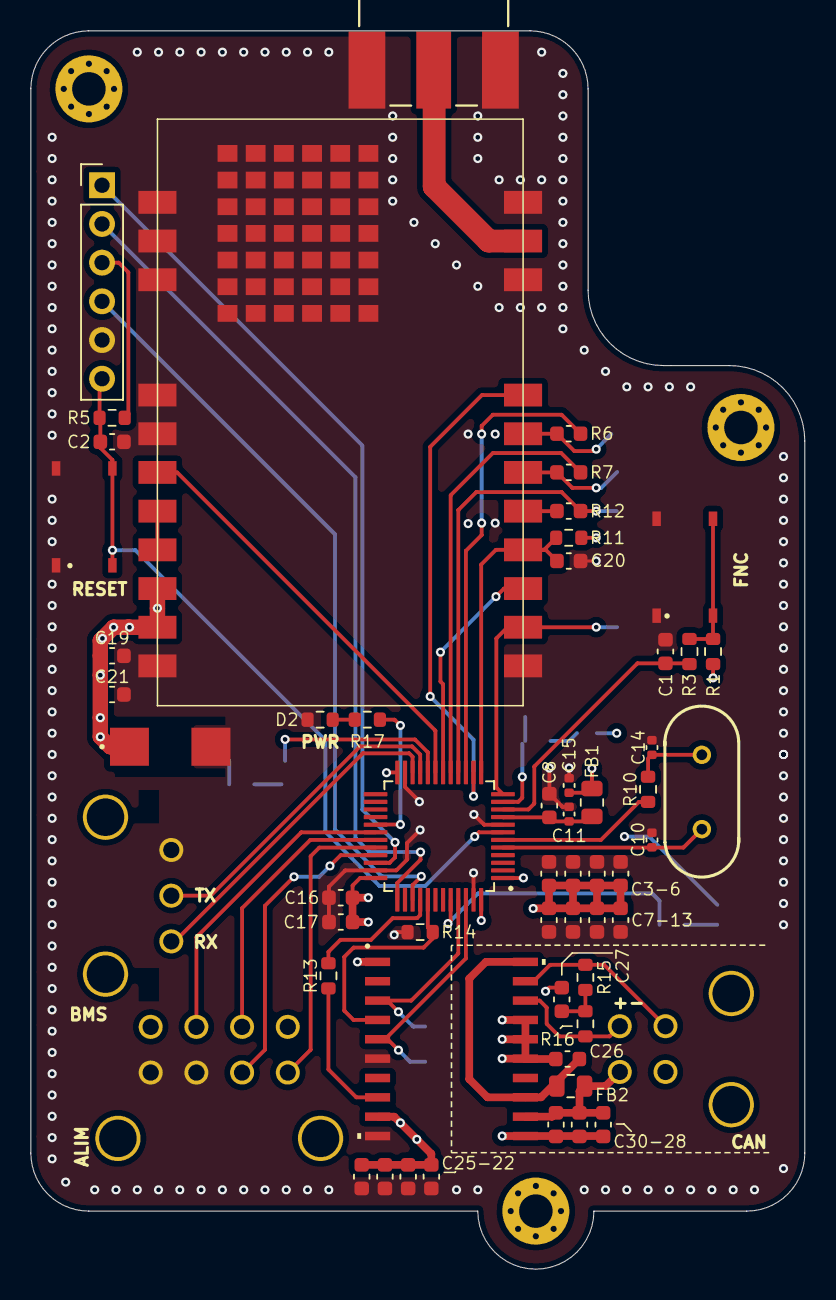
[picture p18: board EchoLink.kicad_pcb from above]

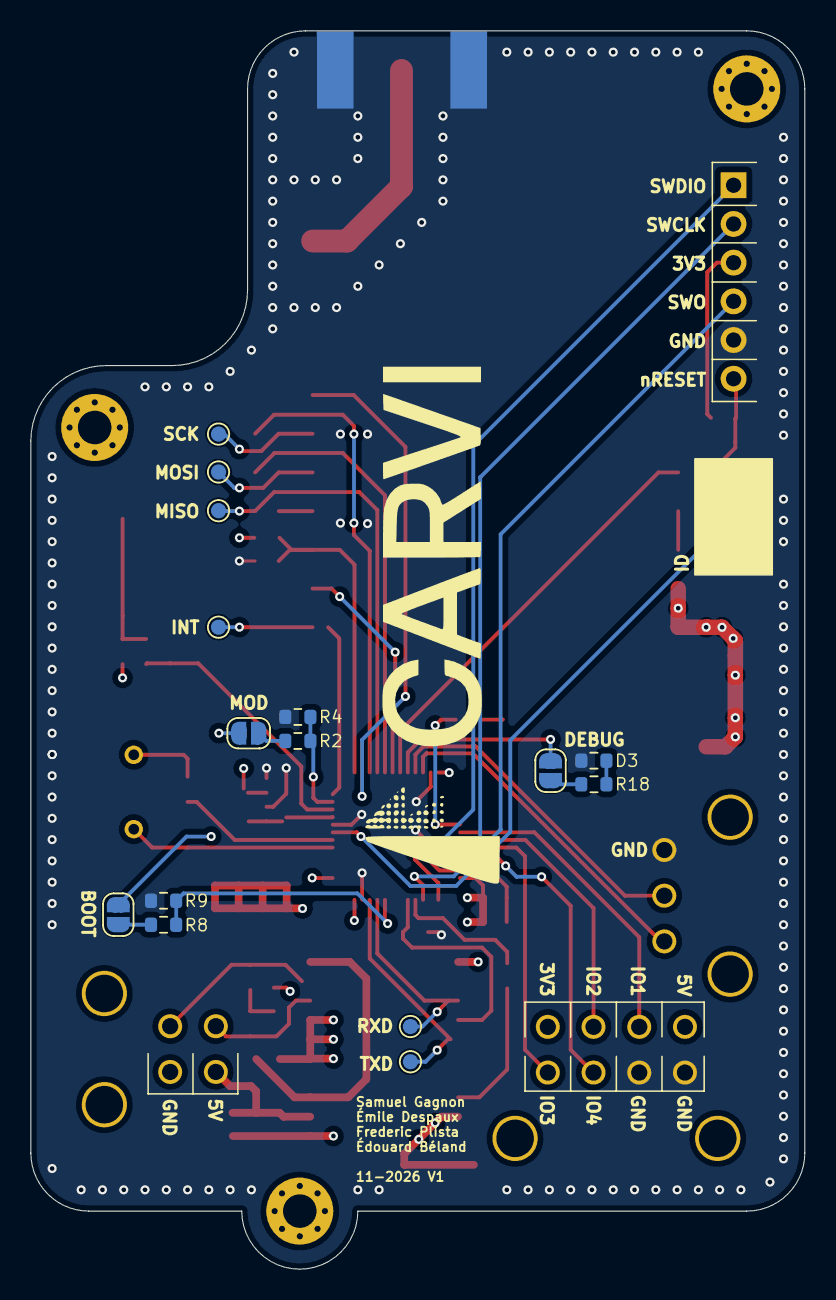
[picture p19: board EchoLink.kicad_pcb from below]

Board: 4 copper layers, 50.8 x 81.3 mm, 76 parts (16 on the bottom side), 52 nets.

Other parts of the board:
C3-6: 4.7uF; C_0603_1608Metric
C7-13: 100nF; C_0603_1608Metric
C25-22, C30-28: 10uF; C_0603_1608Metric
G1: LOGO; Carvi

Their connections:
+3V3: C3-6.1, C7-13.1, C25-22.1; also elsewhere on the board
+5VAiso: C30-28.1; also elsewhere on the board
GND: C3-6.2, C7-13.2, C25-22.2; also elsewhere on the board
GND_iso: C30-28.2; also elsewhere on the board
