DesignIV-Equipe4/EchoLink/STM32CubeIDE/EchoLink/EchoLink.ioc

Mcu.UserName=STM32L433CCTx
PA0.GPIO_Label=SYS_FNC
PA0.Signal=SYS_WKUP1
PA1.GPIO_Label=MOD_OPT
PA1.Signal=GPIO_Input
PA10.GPIO_Label=PWR_IO2
PA10.Signal=GPIO_Output
PA11.GPIO_Label=PWR_IO3
PA11.Signal=GPIO_Output
PA12.GPIO_Label=PWR_IO4
PA12.Signal=GPIO_Output
PA2.GPIO_Label=LORA_INT
PA2.Signal=SYS_WKUP4
PA3.GPIO_Label=LORA_nRST
PA3.Signal=GPIO_Output
PA4.GPIO_Label=LORA_SPI1_NSS
PA4.Signal=GPIO_Output
PA5.GPIO_Label=LORA_SPI1_SCK
PA5.Signal=SPI1_SCK
PA6.GPIO_Label=LORA_SPI1_MISO
PA6.Signal=SPI1_MISO
PA7.GPIO_Label=LORA_SPI1_MOSI
PA7.Signal=SPI1_MOSI
PA8.GPIO_Label=PWR_LPTIM2_OUT
PA8.Signal=LPTIM2_OUT
PA9.GPIO_Label=PWR_IO1
PA9.Signal=GPIO_Output
PB0.GPIO_Label=LORA_BUSY
PB0.Signal=GPIO_Input
PB1.GPIO_Label=LORA_RXEN
PB1.Signal=GPIO_Output
PB10.GPIO_Label=BMS_LPUART1_RX
PB10.Signal=LPUART1_RX
PB11.GPIO_Label=BMS_LPUART1_TX
PB11.Signal=LPUART1_TX
PB15.GPIO_Label=PWR_SPEED
PB15.Signal=GPXTI15
PB2.GPIO_Label=DEBUG_LPTIM1_OUT
PB2.Signal=LPTIM1_OUT
PB5.GPIO_Label=ISO_STB
PB5.Signal=GPIO_Output
PB8.GPIO_Label=ISO_CAN1_RXD
PB8.Signal=CAN1_RX
PB9.GPIO_Label=ISO_CAN1_TXD
PB9.Signal=CAN1_TX
