DesignIV-Equipe4/EchoLink/(commit log)

2026-09-06 chore: add existing stm32/kicad projects
    [142-0701-801.step, 436500404.step, Communication&IOs.kicad_sch, Communication.kicad_sch, Communication_sch.kicad_sch, E22-400M33S.PcbLib, EchoLink.kicad_pcb, EchoLink.kicad_sch]
2026-09-06 chore: cleanup kicad project sheets
    [Communication&IOs.kicad_sch, Communication_sch.kicad_sch]
2026-09-06 wip: add comments in schematic
    [IOs.kicad_sch]
2026-09-08 wip: add 470uF cap to lora module decoupling capacitance
    [Communication.kicad_sch, EEHZU1E471P.step, IOs.kicad_sch]
2026-09-08 wip: update comments
    [EchoLink.kicad_sch]
2026-09-10 wip: rename compoents
    [Communication.kicad_sch, EchoLink.kicad_sch, IOs.kicad_sch]
2026-09-13 wip: connector and bms IOs
    [Communication.kicad_sch, EchoLink.kicad_sch, IOs.kicad_sch]
2026-10-04 fix: rework all schematics to fit with new design and update stm32cubemx project
    [Communication.kicad_sch, EchoLink.kicad_sch, IOs.kicad_sch, ISOW1044BDFMR.stp]
2026-10-05 wip: add missing footprints
    - connectors missing
    [Communication.kicad_sch, EchoLink.kicad_sch, IOs.kicad_sch]
2026-10-05 wip: ERC
    [Communication.kicad_sch, EchoLink.kicad_sch]
2026-10-05 wip: pcb stackup layers and drafted edges
    [EchoLink.kicad_pcb]
2026-10-05 wip: pcb components
    [EchoLink.kicad_pcb]
2026-10-06 wip: positionning and polygon planes
    [Communication.kicad_sch, EchoLink.kicad_pcb]
2026-10-06 wip: add hse crystal and update stm32 project (clock 80MHz and 500kbps CAN)
    [Communication.kicad_sch, EchoLink.kicad_pcb, EchoLink.kicad_sch, IOs.kicad_sch, WE-XTAL_HC49.step]
2026-11-02 wip: draft pcb
2026-11-02 wip: update ioc project and remove extend io connection on stm32 kciad
2026-11-09 wip: edit lora busy connection and update pcb routing
2026-11-09 wip: add debug led and some trace fixes
2026-11-10 wip: fix routing, remove tvs from function button, remove borders mask, add via fencing, silkscreens and update bom
2026-11-10 wip: pcbway packaging
2026-11-11 wip: update 3v3 trace debugger
2026-11-11 feat: first draft of sx1268 driver
